tech-nickk2/Edge-AI-Camera-Trap/images/README.md

# images/

Photos used in the main README. Add them with these names, or change the names in the README:

| File | Shows |
|---|---|
| `prototype.jpg` | The finished camera trap (top of the README) |
| `electronics.jpg` | The electronics inside the case |
| `edge-impulse-results.png` | Edge Impulse training results |
| `wiring.jpg` | Wiring diagram or photo of the sensors |
| `test-page.png` | Screenshot of the test web page (camera-trap-app README) |
| `example-capture.jpg` | A labelled photo from `camera-trap-app/data/captures/` |

Keep each image under ~1 MB so the repo stays quick to clone on the UNO Q.
