tech-nickk2/Edge-AI-Camera-Trap/case/README.md

# Case

3D-printable case for the UNO Q, camera, PIR sensor, LDR and IR LEDs.

[EDIT: add STL files, print settings (material, layer height, infill) and assembly notes]
