tech-nickk2/Edge-AI-Camera-Trap/case/Main_body.stl

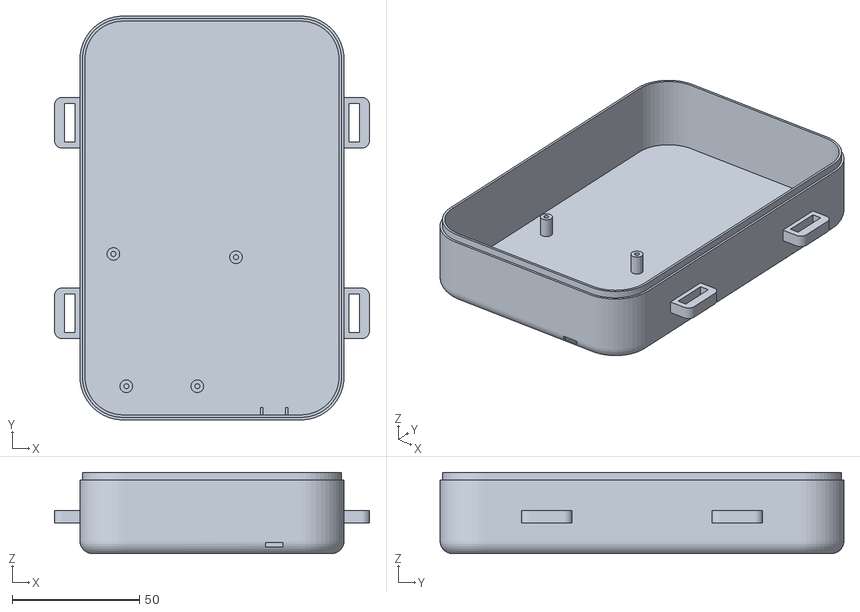
[picture p1: CAD file, 2026-10-22]
case/Main_body.stl
124.0 x 159.0 x 32.0
