tech-nickk2/Edge-AI-Camera-Trap/case/Cover.stl

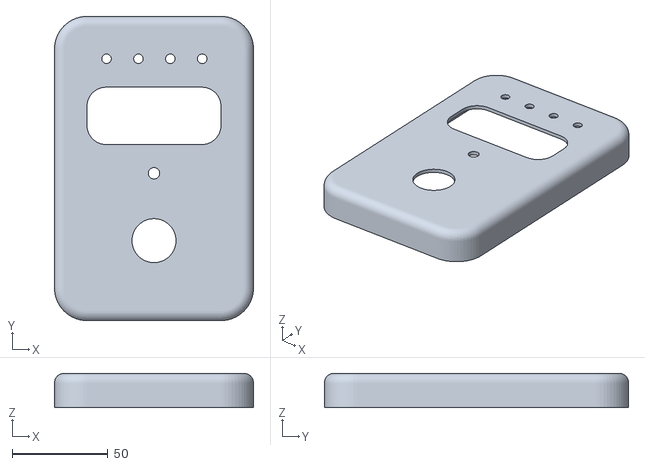
[picture p2: CAD file, 2026-10-22]
case/Cover.stl
104.0 x 159.0 x 18.0
